NNMRduino/NMRduino/Hardware/index.md

# PCB Gerber files for NMRduino

## Description

Gerber files for PCB manufacture. The files use standard naming conventions for a two-layer PCB.

[Download the Gerber ZIP file](./NMRduino-GERBER-Rev0923.zip)

Quick links:

- [NMRduino schematic (PDF)](./NMRduino-1_0-schematic-251212.pdf)
- [NMRduino bill of materials (Excel)](./Bill%20of%20materials.xlsx)

## License

The NMRduino hardware designs are released under the [Creative Commons Attribution-ShareAlike 4.0 International licence](https://creativecommons.org/licenses/by-sa/4.0/). By using the NMRduino hardware designs, you agree to the terms of this licence.
