NNMRduino/NMRduino/Hardware/Bill of materials.xlsx

NMRduino bill of materials | Updated: Jul 2026
Component parts | Qty | Package | Link to supplier | Manufacturer
LTC1859 (IG or CG ok) | 1 | SSOP-28 | https://www.mouser.es/en/ProductDetail/Analog-Devices/LTC1859CGPBF?qs=hVkxg5c3xu8%2F7KS0qTGClw%3D%3D | ANALOG DEVICES
1.0 uF polarized capacitor | 1 | 3216 | https://www.mouser.es/en/ProductDetail/Vishay-Sprague/TR3A105K035C3000 | VISHAY
10 uF polarized capacitor | 4 | 3216 | https://www.mouser.es/en/ProductDetail/Vishay-Sprague/TL3A106K016C1700 | VISHAY
0.1 uF ceramic capacitor | 5 | 0603 | https://www.mouser.es/en/ProductDetail/KYOCERA-AVX/KAM15AR71C104KM?qs=Jm2GQyTW%2FbjvjfiJhcHTCg%3D%3D | KYOCERA
MCP4822 |  | SO8 | https://www.mouser.es/en/ProductDetail/Microchip-Technology/MCP4822T-E-SN?qs=MLItCLRbWsyc6ayz%252BPX81Q%3D%3D | MICROCHIP
0805 10k resistor | 2 |  | https://www.mouser.es/en/ProductDetail/Panasonic/ERA-6AED103V?qs=MNPzkKEzRtSGdYymydDO9g%3D%3D | PANASONIC
0805 39k resistor | 2 |  | https://www.mouser.es/en/ProductDetail/Panasonic/ERA-6ARB393V?qs=ob%252BdNz2%252BYEgpGyZc7aAYhw%3D%3D | PANASONIC
Male headers, 2.54 mm pitch, 6 pin | 1 |  | https://www.mouser.es/en/ProductDetail/Amphenol-Commercial-Products/G800W302018EU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 | AMPHENOL
Male headers, 2.54 mm pitch, 9 pin | 1 |  | https://www.mouser.es/en/ProductDetail/Adam-Tech/PH1-09-UA?qs=HoCaDK9Nz5c3mwAnb4EJIQ%3D%3D | ADAM TECH
Male headers, 2.54 mm pitch, 15 pin | 1 |  | https://www.mouser.es/en/ProductDetail/Adam-Tech/PH1-15-UA?qs=HoCaDK9Nz5dUS47ZXPBTBg%3D%3D | ADAM TECH
Female headers, 2.54 mm pitch, 10 pin | 2 |  | https://www.mouser.es/en/ProductDetail/Wurth-Elektronik/61301011821?qs=W%252B2sBeLta1ZhlLR0YCzonQ%3D%3D | WÜRTH ELEKTRONIK
Female headers, 2.54 mm pitch, 14 pin | 2
Female headers, 2.54 mm pitch, 17 pin | 2 |  | https://www.mouser.es/en/ProductDetail/Harwin/M20-7821746?qs=ulE8k0yEMYbMKlq16wSEPQ%3D%3D | HARWIN
SMA through hole, standard polarity | 7 |  | https://www.mouser.es/en/ProductDetail/Samtec/SMA-J-P-H-ST-TH1?qs=bkXRl3BLxbHdaAB2Qwy6zw%3D%3D | SAMTEC
BNC through hole, standard polarity | 3 |  | https://www.mouser.es/en/ProductDetail/Amphenol-RF/112404?qs=1K%2FD%252BSl2CTNlg0LiPKjnoQ%3D%3D | AMPHENOL
Modular parts
Teensy 4.1 MCU, ethernet optional | 1 |  | https://www.pjrc.com/store/teensy41.html
DRV8835 | 2 |  | https://www.pololu.com/product/2135
DRV8838 | 2 |  | https://www.pololu.com/product/2990
