NNMRduino/NMRduino/Hardware/NMRduino-1_0-schematic-251212.pdf

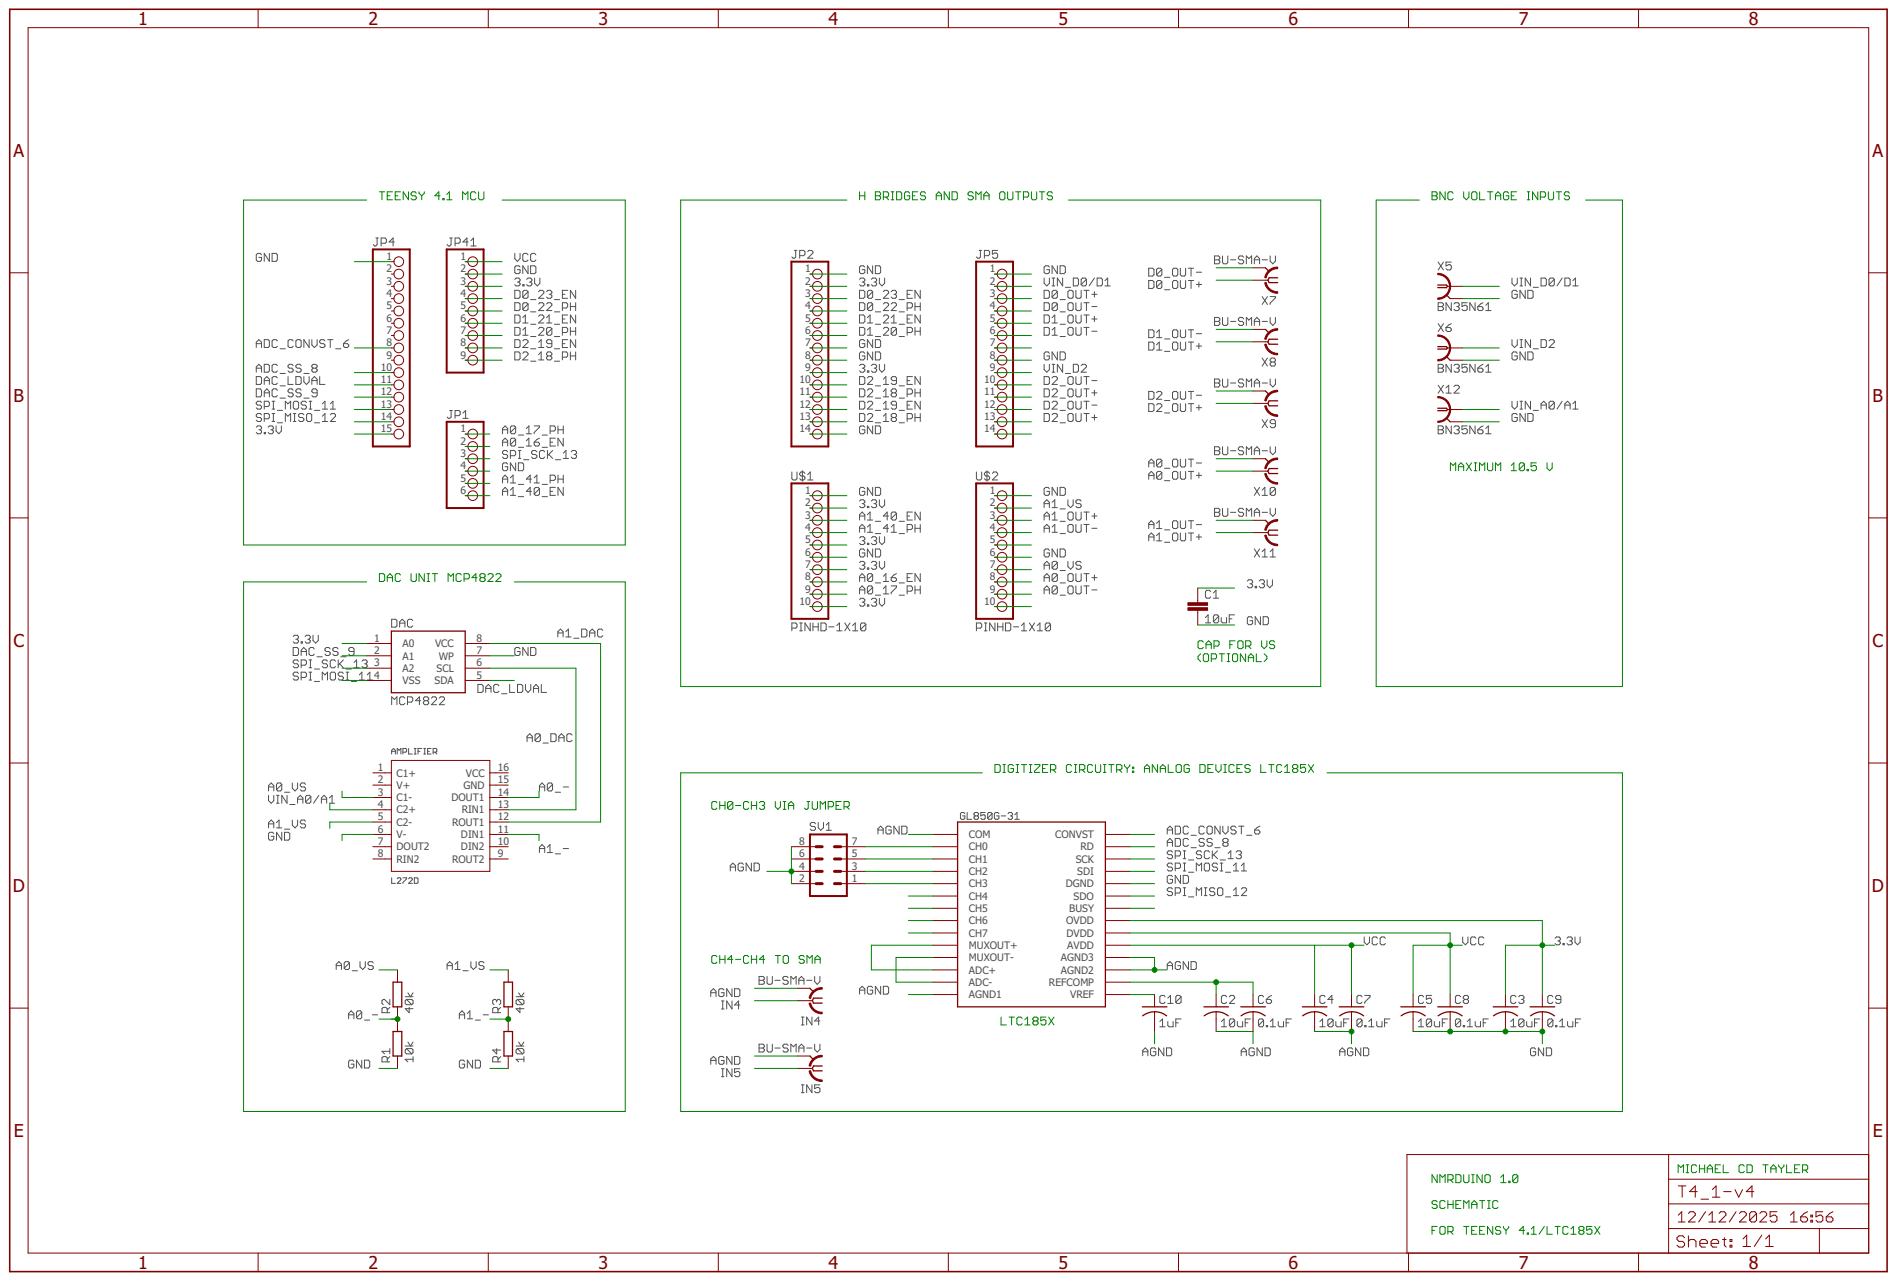
[picture p1: page 1]
