NNMRduino/NMRduino/Software/MCU/latest/NMRduino_v1.02-GPL3-release/NMRduino_v1.02-GPL3-release.ino

/*  NMRduino open core version 1.02
*   Compatible with Teensy 4.1 and NMRduino UI version(s) 3.35
*   Copyright (C) 2026, by Michael Tayler and Sven Bodenstedt
*
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
* You should have received a copy of the GNU General Public License
* along with this program.  If not, see <http://www.gnu.org/licenses/>.
*/

enum State {State_Idle, State_Init, State_Sequence, State_Acquire, State_Transfer, State_GPIO_change, State_acq_get, State_acq_rtn, State_dac_rtn, State_acq_point_init}; //, State_Flush};
volatile State state = State_Idle;
#include "serial.h"

void setup(){ 
  state=State_Idle;
  Serial_init();
  }
  
void loop(){
switch (state)
  {
  case State_Idle:
    while(readSerialData()){}
    state = State_Init;
  break;
      
  case State_Init: 
    seq_run();
  break;

  case State_Transfer:
    transfer_data(n_data_points);
    delay(1);
    state=State_Idle;
  break;

  default: 
  break;
  }
}
