NNMRduino/NMRduino/(commit log)

2025-12-12 Add files via upload
    Added schematic for NMRduino hardware
2026-06-02 Update MCU firmware v1.01 to v1.02
    Bug fixes due to new compile in Arduino IDE
    [LTC1859.h, MCP4822.h, NMRduino_v1.01-GPL3-release.ino, NMRduino_v1.02-GPL3-release.ino, QTM.h, sequences.h, serial.h]
2026-07-30 BOM upload
    [Bill of materials.xlsx]
2026-07-30 Add hardware section to README
    Added hardware section with a link to the Bill of Materials.
2026-08-06 Update Hardware/index.md with quick links
    Added quick links for schematic and bill of materials.
2026-08-06 Fix links to schematic and bill of materials
2026-08-06 Revise PCB Gerber files documentation
    Updated the description and links for clarity and consistency.
