NNMRduino/NMRduino/(notices)

Notices in the files:
Software/MCU/latest/NMRduino_v1.02-GPL3-release/NMRduino_v1.02-GPL3-release.ino:
This program is free software: you can redistribute it and/or modify
it under the terms of the GNU General Public License as published by
the Free Software Foundation, version 3 of the License.
